MaTeJDVora12345/Linefollower/LF_3.0 - 26inter/KiCad/teensy41pinout.png

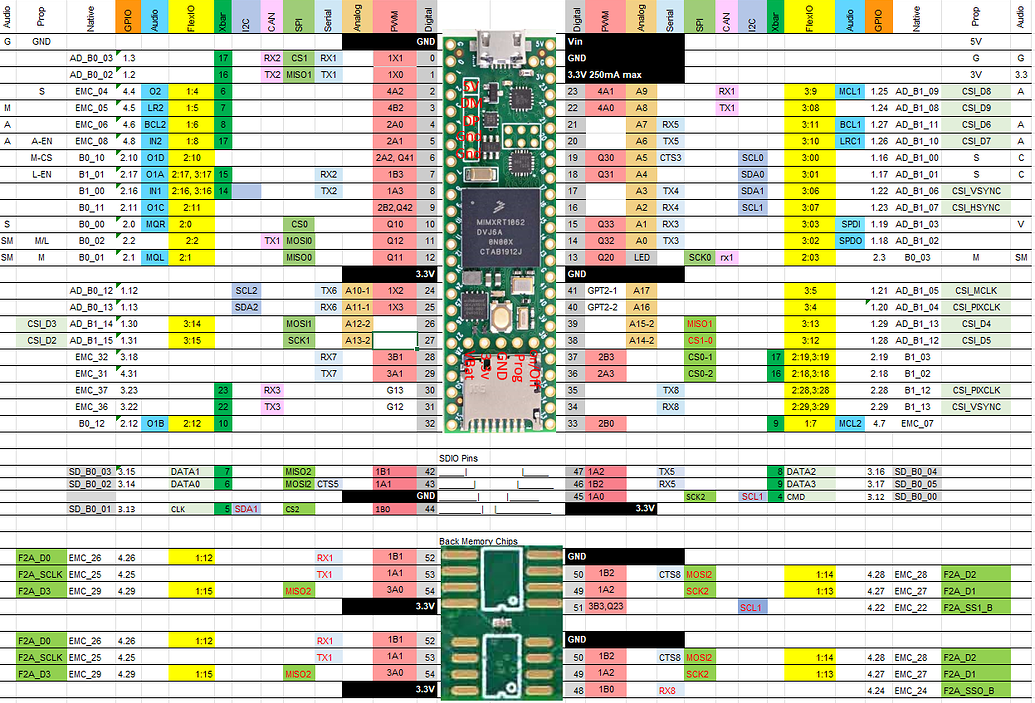
LF_3.0 - 26inter/KiCad/teensy41pinout.png
