MaTeJDVora12345/Linefollower/LF_3.0 - 26inter/KiCad/fusion/LinefollowerV4.step

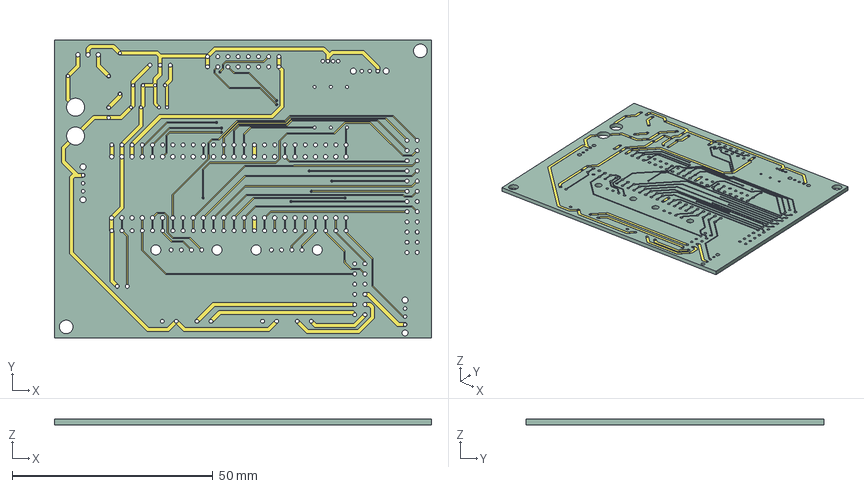
[picture p2: CAD file, 2026-03-14]
LF_3.0 - 26inter/KiCad/fusion/LinefollowerV4.step
94.0 x 74.2 x 1.48 mm
LinefollowerV4_copper
LinefollowerV4_via
LinefollowerV4_PCB
