MaTeJDVora12345/Linefollower/LF_3.0 - 26inter/KiCad/fusion/LinefollowerV4-B_Cu.dxf

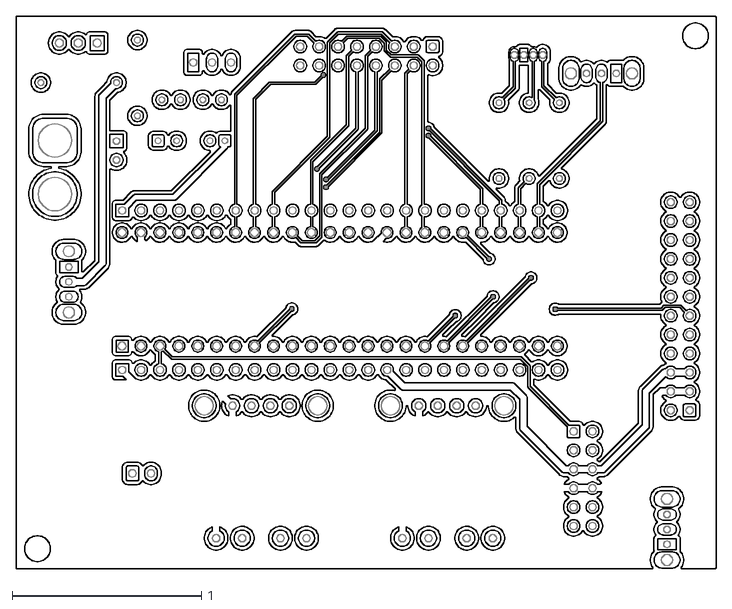
[picture p4: CAD file, 2026-03-14]
LF_3.0 - 26inter/KiCad/fusion/LinefollowerV4-B_Cu.dxf
3.70 x 2.92
