MaTeJDVora12345/Linefollower/LF_3.0 - 26inter/technicalDocumentation/technicalDraw.pdf

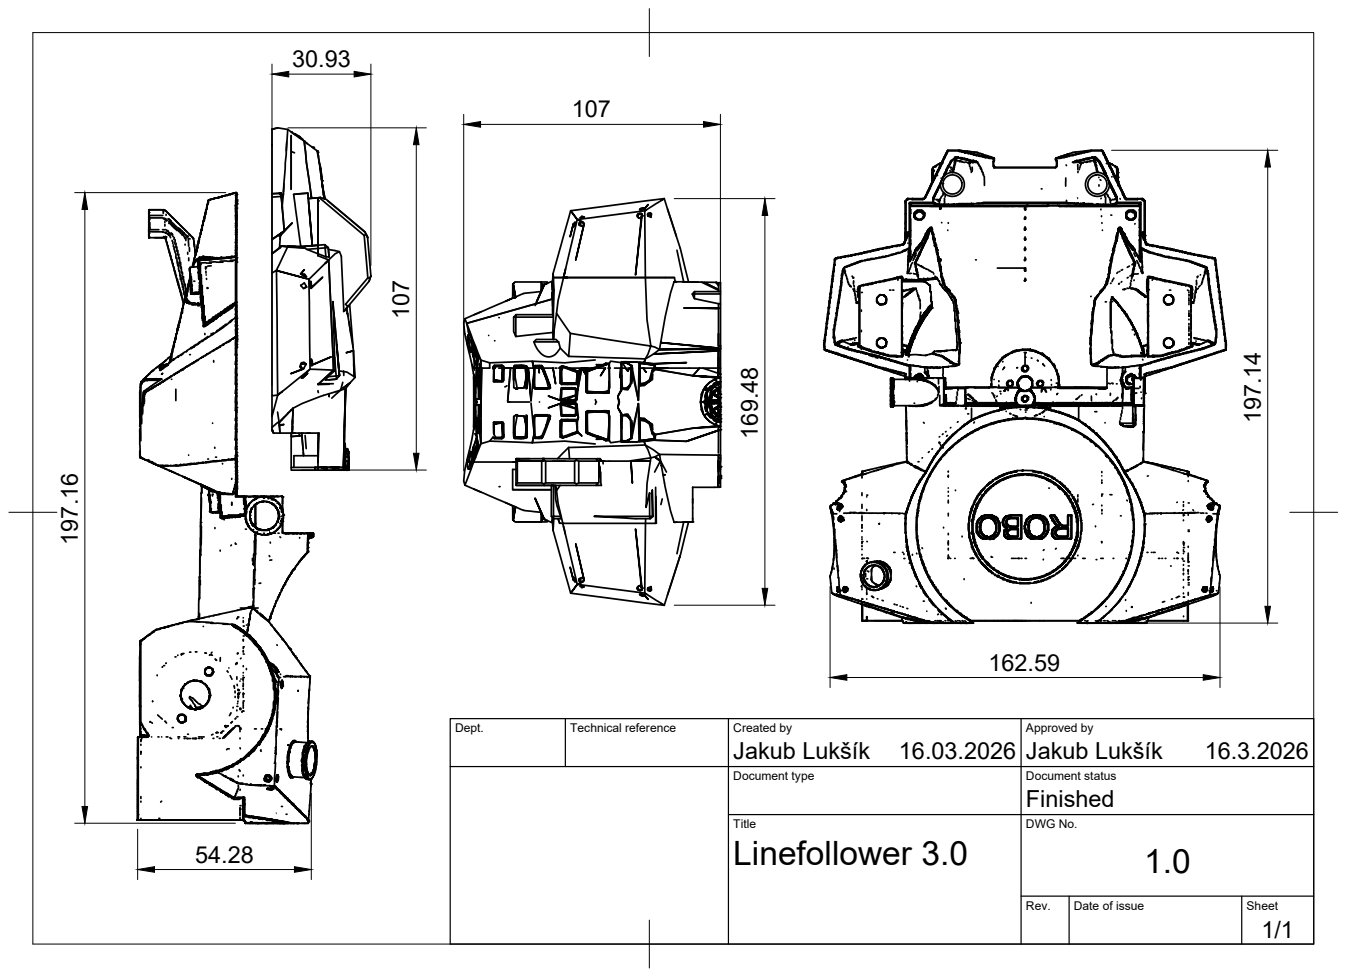
[picture p5: page 1]
Dept.; Technical reference; Created by; Approved by; Document type; Document status; Title; DWG No.; Rev.; Date of issue; Sheet; Linefollower 3.0; Jakub Lukšík; Jakub Lukšík 197.16
