MaTeJDVora12345/Linefollower/LF_3.0 - 26inter/KiCad/LinefollowerV4/LinefollowerV4.kicad_pcb

## KiCad design LF_3.0 - 26inter/KiCad/LinefollowerV4/LinefollowerV4.kicad_pcb (2026-03-14)

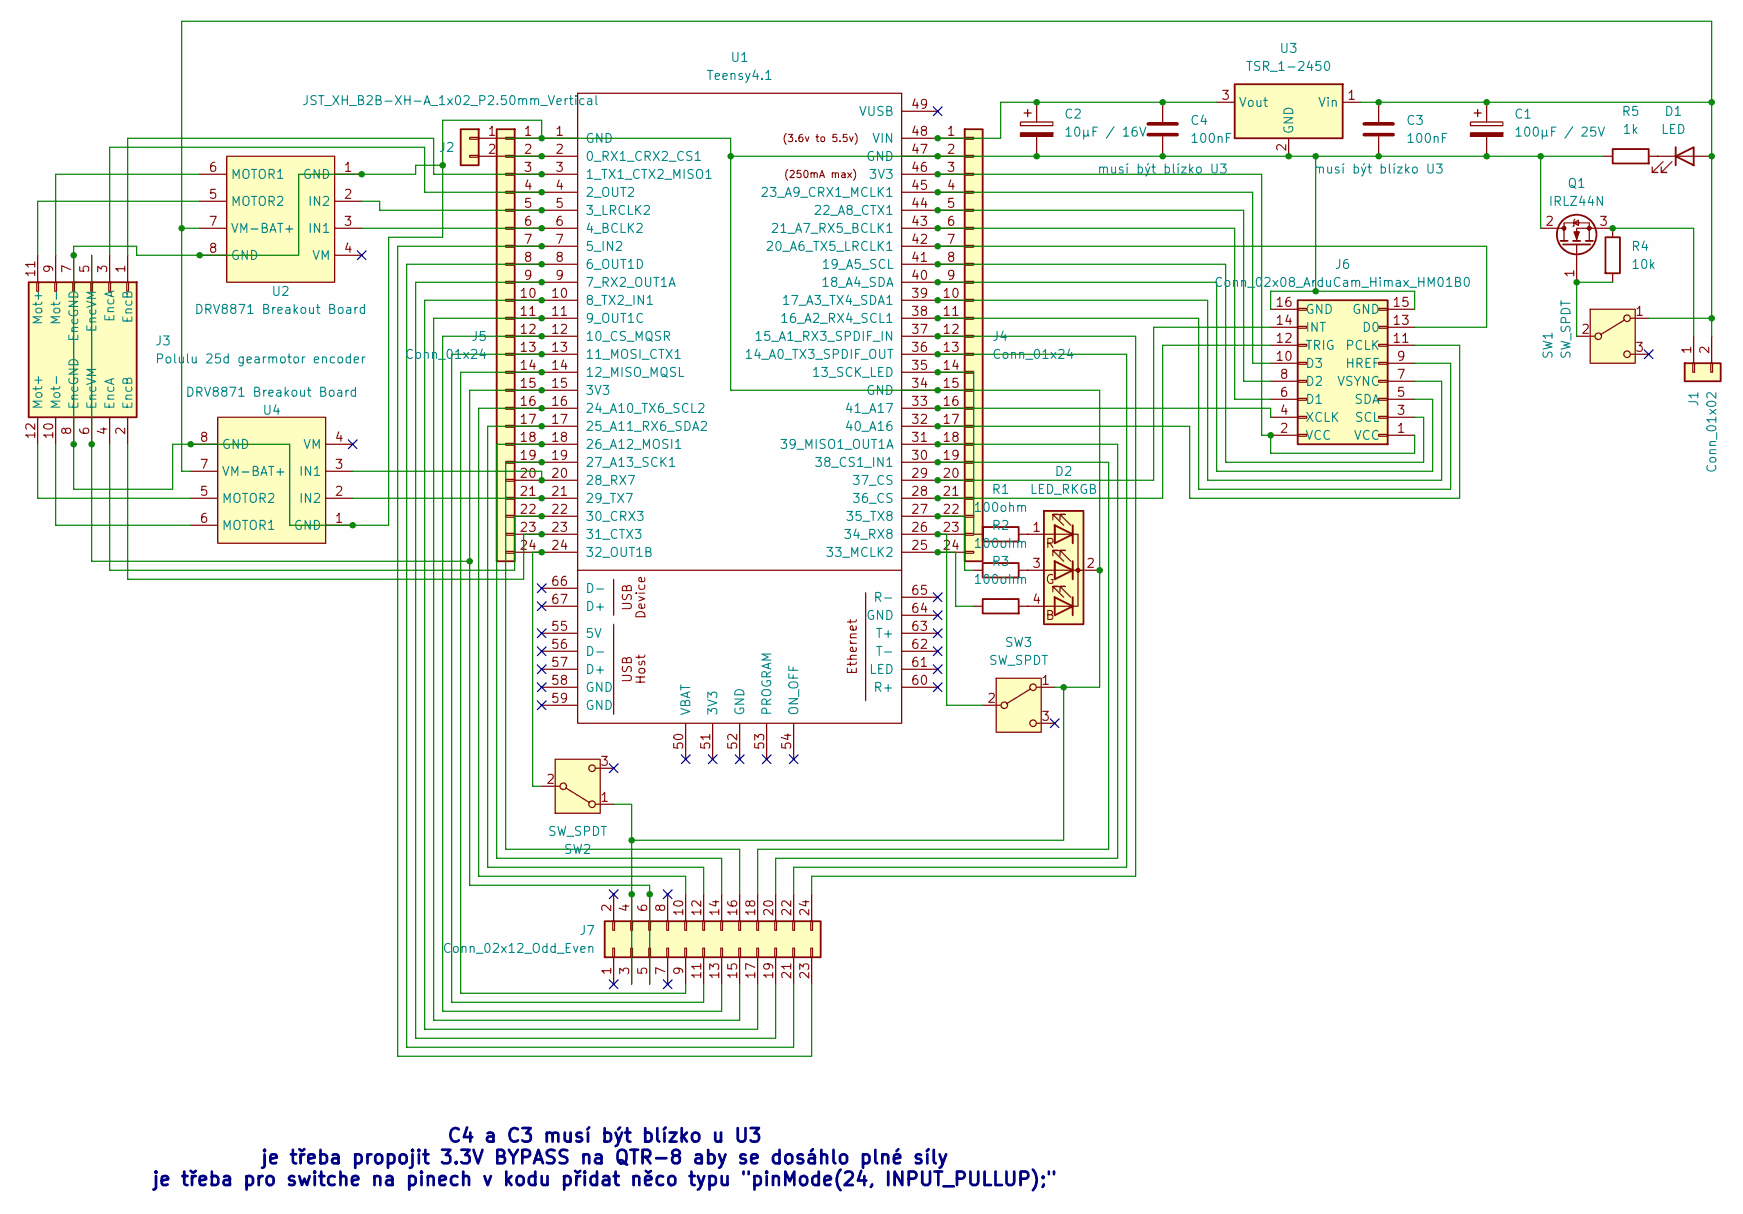
[picture p6: schematic LinefollowerV4.kicad_sch]

Parts:
C1: 100µF / 25V; CP_Radial_D6.3mm_P2.50mm
C2: 10µF / 16V; CP_Radial_D5.0mm_P2.00mm
C3, C4: 100nF; C_Disc_D5.0mm_W2.5mm_P2.50mm
D1: LED; LED_D5.0mm
D2: LED_RKGB; LED_RKBG_D5.0mm-4_RGB
J1: Conn_01x02; AMASS_XT60-M_1x02_P7.20mm_Vertical
J2: JST_XH_B2B-XH-A_1x02_P2.50mm_Vertical
J3: Polulu 25d gearmotor encoder; IDC-Header_2x06_P2.54mm_Vertical
J4, J5: Conn_01x24; PinHeader_1x24_P2.54mm_Vertical
J6: Conn_02x08_ArduCam_Himax_HM01B0; IDC-Header_2x08_P2.54mm_Vertical
J7: Conn_02x12_Odd_Even; IDC-Header_2x12_P2.54mm_Vertical_3D
Q1: IRLZ44N; TO-220-3_Vertical
R1, R2, R3: 100ohm; R_Axial_DIN0207_L6.3mm_D2.5mm_P10.16mm_Horizontal
R4: 10k; R_Axial_DIN0207_L6.3mm_D2.5mm_P10.16mm_Horizontal
R5: 1k; R_Axial_DIN0207_L6.3mm_D2.5mm_P10.16mm_Horizontal
SW1, SW2, SW3: SW_SPDT; SW_Slide_SPDT_Angled_CK_OS102011MA1Q
U1: Teensy4.1; Teensy41
U2, U4: DRV8871 Breakout Board
U3: TSR_1-2450; Converter_DCDC_TRACO_TSR-1_THT

Connections:
unnamed: C1.1, C3.1, D1.2 (A), J1.2, SW1.1 (A), U2.7 (VM-BAT+), U3.1 (Vin), U4.7 (VM-BAT+)
unnamed: D1.1 (K), R5.2
unnamed: D2.4 (BA), R3.2
unnamed: D2.3 (GA), R2.2
unnamed: C1.2, C2.2, C3.2, C4.2, D2.2 (K), J2.1, J3.7 (EncGND), J3.8 (EncGND), J4.2, J4.15, J5.1, J6.15 (GND), J6.16 (GND), J7.3, J7.4, Q1.2 (D), R5.1, SW2.1 (A), SW3.1 (A), U1.1 (GND), U1.34 (GND), U1.47 (GND), U2.1 (GND), U2.8 (GND), U3.2 (GND), U4.1 (GND), U4.8 (GND)
unnamed: D2.1 (RA), R1.2
unnamed: J1.1, Q1.3 (S), R4.1
unnamed: J2.2, J5.2, U1.2 (0_RX1_CRX2_CS1)
unnamed: C2.1, C4.1, J4.1, U1.48 (VIN), U3.3 (Vout)
unnamed: J4.3, J6.1 (VCC), J6.2 (VCC), U1.46 (3V3)
unnamed: J4.4, J6.10 (D3), U1.45 (23_A9_CRX1_MCLK1)
unnamed: J4.5, J6.8 (D2), U1.44 (22_A8_CTX1)
unnamed: J4.6, J6.6 (D1), U1.43 (21_A7_RX5_BCLK1)
unnamed: J4.7, J6.13 (D0), U1.42 (20_A6_TX5_LRCLK1)
unnamed: J4.8, J6.3 (SCL), U1.41 (19_A5_SCL)
unnamed: J4.9, J6.5 (SDA), U1.40 (18_A4_SDA)
unnamed: J4.10, J6.7 (VSYNC), U1.39 (17_A3_TX4_SDA1)
unnamed: J4.11, J6.9 (HREF), U1.38 (16_A2_RX4_SCL1)
unnamed: J4.12, J7.24, U1.37 (15_A1_RX3_SPDIF_IN)
unnamed: J4.13, J7.22, U1.36 (14_A0_TX3_SPDIF_OUT)
unnamed: J4.14, R1.1, U1.35 (13_SCK_LED)
unnamed: J4.16, J6.4 (XCLK), U1.33 (41_A17)
unnamed: J4.17, J6.11 (PCLK), U1.32 (40_A16)
unnamed: J4.18, J7.20, U1.31 (39_MISO1_OUT1A)
unnamed: J4.19, J7.18, U1.30 (38_CS1_IN1)
unnamed: J4.20, J6.14 (INT), U1.29 (37_CS)
unnamed: J4.21, J6.12 (TRIG), U1.28 (36_CS)
unnamed: J4.22, R2.1, U1.27 (35_TX8)
unnamed: J4.23, SW3.2 (B), U1.26 (34_RX8)
unnamed: J4.24, R3.1, U1.25 (33_MCLK2)
unnamed: J3.1 (EncB), J5.3, U1.3 (1_TX1_CTX2_MISO1)
unnamed: J3.3 (EncA), J5.4, U1.4 (2_OUT2)
unnamed: J5.5, U1.5 (3_LRCLK2), U2.2 (IN2)
unnamed: J5.6, U1.6 (4_BCLK2), U2.3 (IN1)
unnamed: J5.7, J7.23, U1.7 (5_IN2)
unnamed: J5.8, J7.21, U1.8 (6_OUT1D)
unnamed: J5.9, J7.19, U1.9 (7_RX2_OUT1A)
unnamed: J5.10, J7.17, U1.10 (8_TX2_IN1)
unnamed: J5.11, J7.15, U1.11 (9_OUT1C)
unnamed: J5.12, J7.13, U1.12 (10_CS_MQSR)
unnamed: J5.13, J7.11, U1.13 (11_MOSI_CTX1)
unnamed: J5.14, J7.9, U1.14 (12_MISO_MQSL)
unnamed: J3.5 (EncVM), J3.6 (EncVM), J5.15, J7.5, J7.6, U1.15 (3V3)
unnamed: J5.16, J7.10, U1.16 (24_A10_TX6_SCL2)
unnamed: J5.17, J7.12, U1.17 (25_A11_RX6_SDA2)
unnamed: J5.18, J7.14, U1.18 (26_A12_MOSI1)
unnamed: J5.19, J7.16, U1.19 (27_A13_SCK1)
unnamed: J5.20, U1.20 (28_RX7), U4.3 (IN1)
unnamed: J5.21, U1.21 (29_TX7), U4.2 (IN2)
unnamed: J3.4 (EncA), J5.22, U1.22 (30_CRX3)
unnamed: J3.2 (EncB), J5.23, U1.23 (31_CTX3)
unnamed: J5.24, SW2.2 (B), U1.24 (32_OUT1B)
unnamed: Q1.1 (G), R4.2, SW1.2 (B)
unnamed: J3.9 (Mot-), U2.6 (MOTOR1)
unnamed: J3.11 (Mot+), U2.5 (MOTOR2)
unnamed: J3.10 (Mot-), U4.6 (MOTOR1)
unnamed: J3.12 (Mot+), U4.5 (MOTOR2)

Notes on the sheet:
C4 a C3 musí být blízko u U3 je třeba propojit 3.3V BYPASS na QTR-8 aby se dosáhlo plné síly je třeba pro switche na pinech v kodu přidat něco typu "pinMode(24, INPUT_PULLUP);"

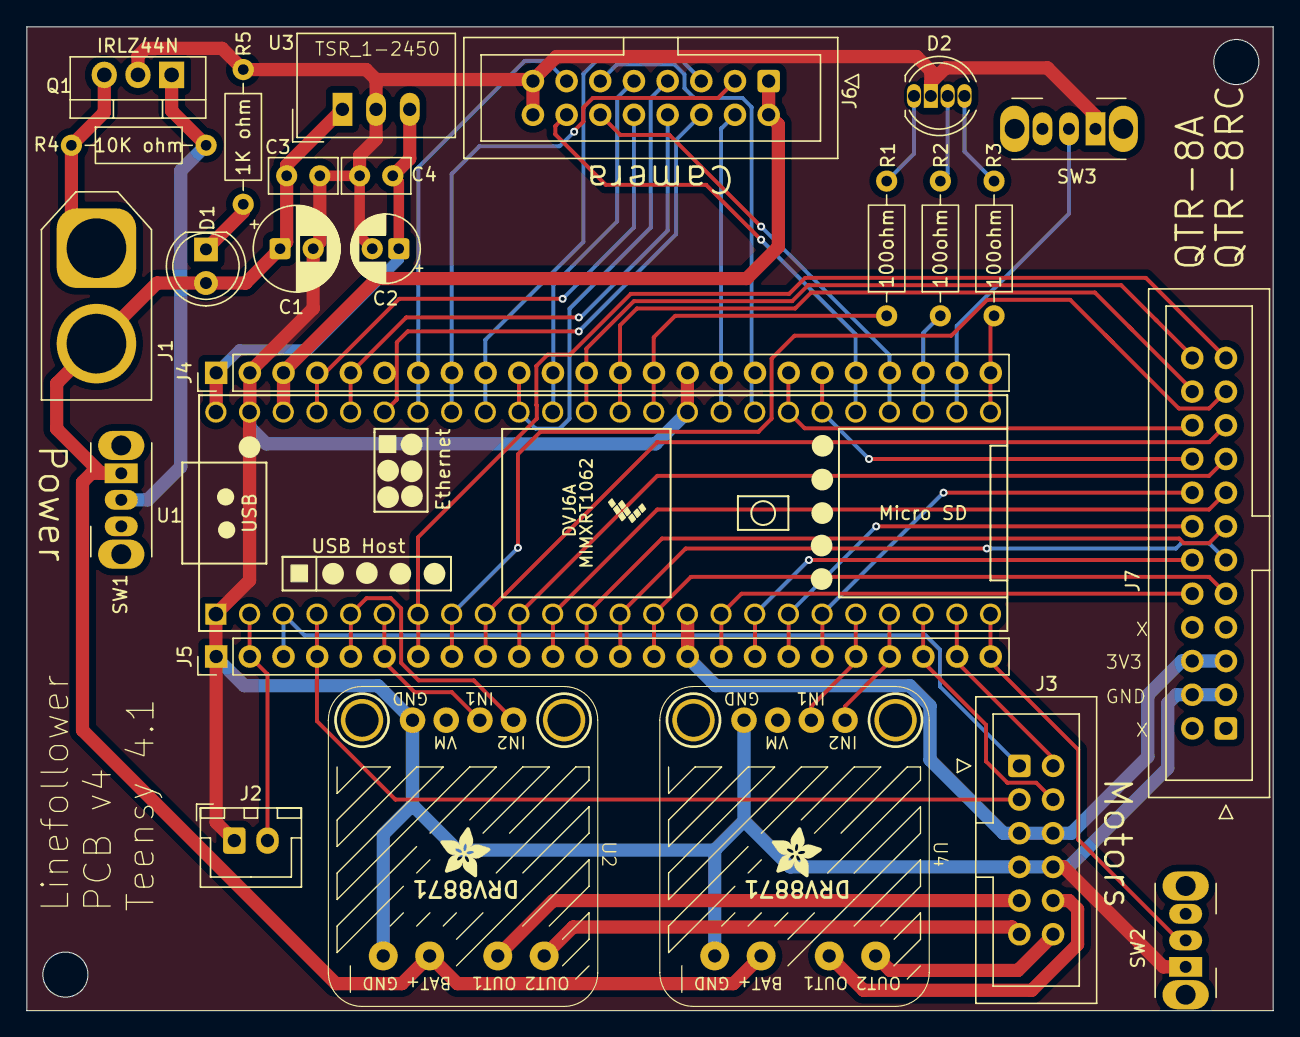
[picture p7: board LinefollowerV4.kicad_pcb from above]

Board: 2 copper layers, 94.0 x 74.2 mm, 26 parts (0 on the bottom side), 57 nets.
