MaTeJDVora12345/Linefollower/LF_3.0 - 26inter/KiCad/customPCB/customPCB.kicad_pcb

## KiCad design LF_3.0 - 26inter/KiCad/customPCB/customPCB.kicad_pcb (2026-03-14)

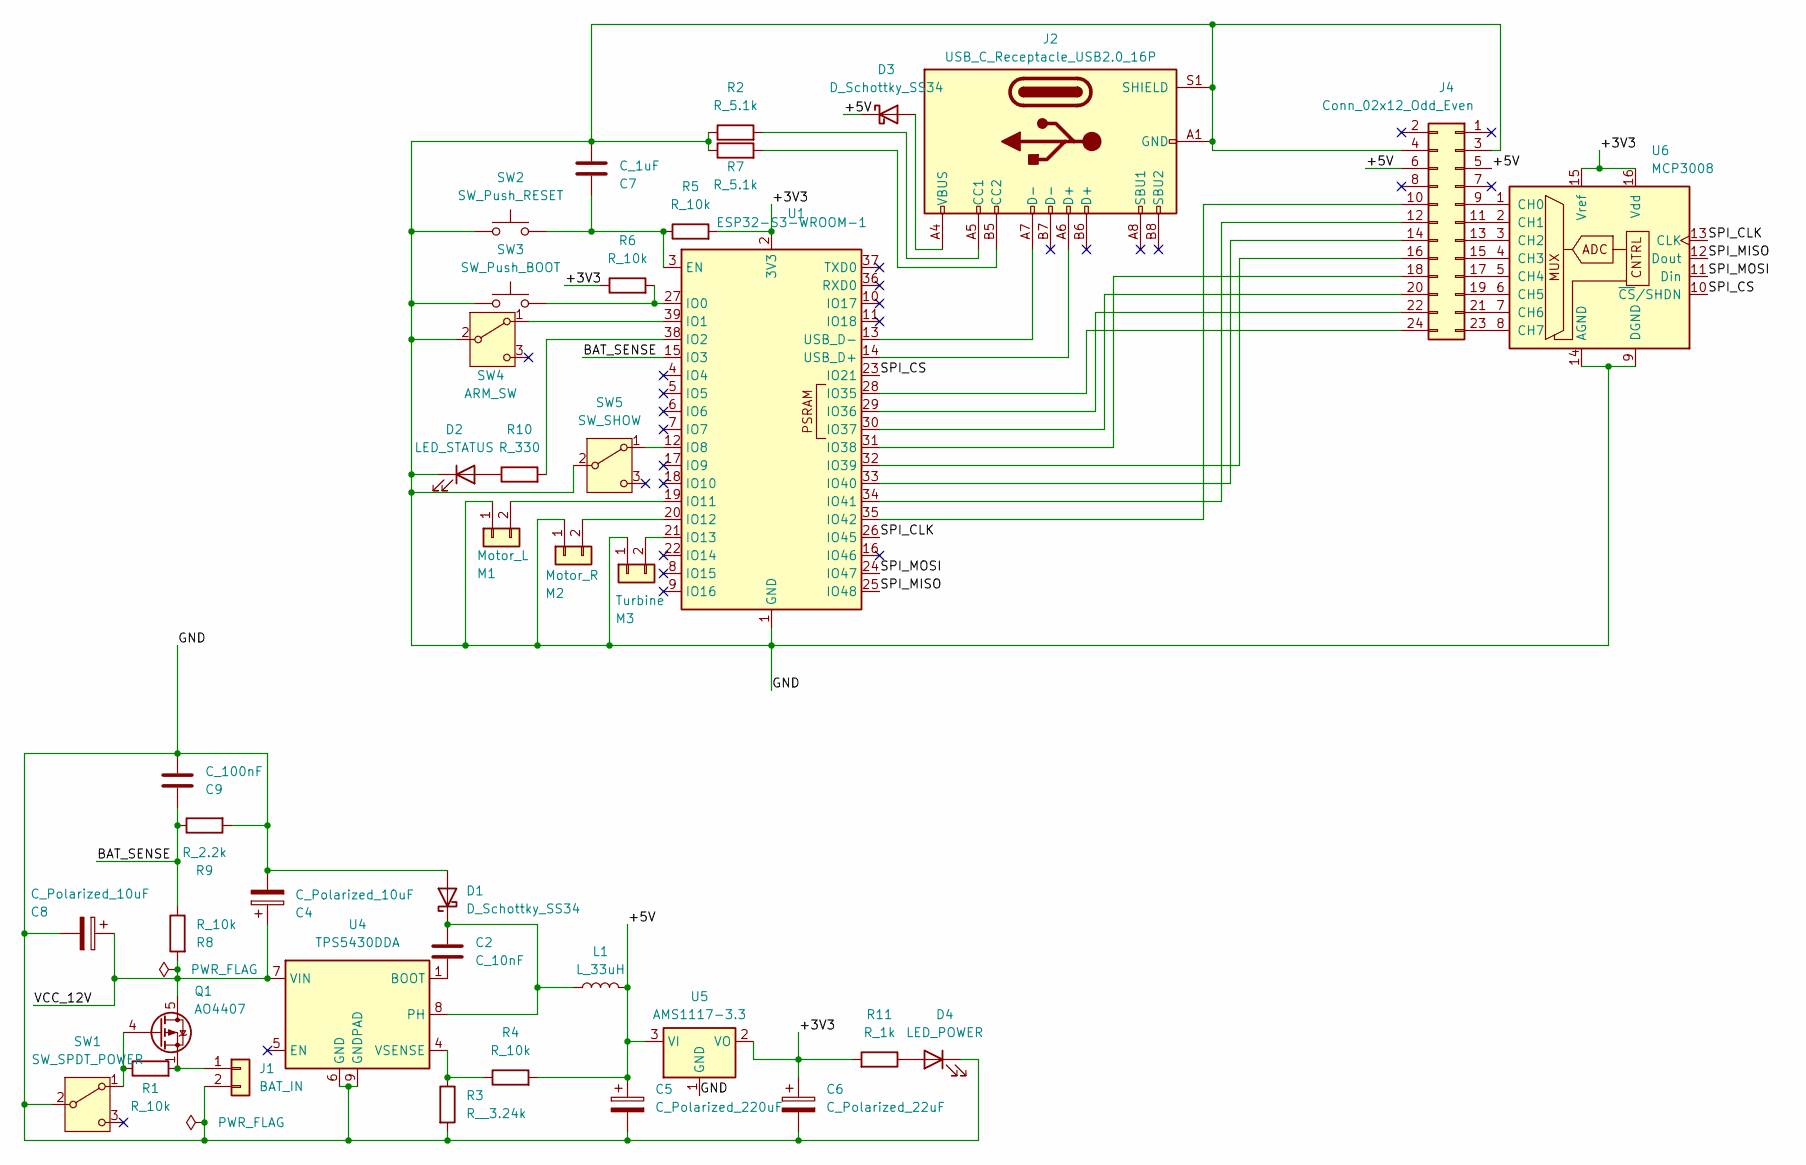
[picture p8: schematic customPCB.kicad_sch, Custom PCB for Linefollower]

Parts:
C2: C_10nF; C_0603_1608Metric
C4, C8: C_Polarized_10uF; C_1206_3216Metric
C5: C_Polarized_220uF; CP_Elec_6.3x5.4
C6: C_Polarized_22uF; C_1206_3216Metric
C7: C_1uF; C_0603_1608Metric
C9: C_100nF; C_0603_1608Metric
D1, D3: D_Schottky_SS34; D_SMA
D2: LED_STATUS; LED_0603_1608Metric
D4: LED_POWER; LED_0603_1608Metric
J1: BAT_IN; AMASS_XT60-F_1x02_P7.20mm_Vertical
J2: USB_C_Receptacle_USB2.0_16P; USB_C_Receptacle_GCT_USB4085
J4: Conn_02x12_Odd_Even; IDC-Header_2x12_P2.54mm_Vertical_3D
L1: L_33uH; L_Taiyo-Yuden_NR-60xx
M1: Motor_L; JST_XH_B2B-XH-A_1x02_P2.50mm_Vertical
M2: Motor_R; JST_XH_B2B-XH-A_1x02_P2.50mm_Vertical
M3: Turbine; JST_XH_B2B-XH-A_1x02_P2.50mm_Vertical
Q1: AO4407; SOIC-8_3.9x4.9mm_P1.27mm
R1, R4, R5, R6, R8: R_10k; R_0603_1608Metric
R2, R7: R_5.1k; R_0603_1608Metric
R3: R__3.24k; R_0603_1608Metric
R9: R_2.2k; R_0603_1608Metric
R10: R_330; R_0603_1608Metric
R11: R_1k; R_0603_1608Metric
SW1: SW_SPDT_POWER; SW_SPDT_PCM12
SW2: SW_Push_RESET; SW_SPST_B3U-1000P
SW3: SW_Push_BOOT; SW_SPST_B3U-1000P
SW4: ARM_SW; SW_SPDT_PCM12
SW5: SW_SHOW; SW_SPDT_PCM12
U1: ESP32-S3-WROOM-1
U4: TPS5430DDA; TI_SO-PowerPAD-8_ThermalVias
U5: AMS1117-3.3; SOT-223-3_TabPin2
U6: MCP3008; SOIC-16_3.9x9.9mm_P1.27mm

Connections:
/+3V3: C6.1, R5.2, R6.1, R11.2, U1.2 (3V3), U5.2 (VO), U6.15 (Vref), U6.16 (Vdd)
/+5V: C5.1, D3.1 (K), J4.5, J4.6, L1.2, R4.2, U5.3 (VI)
/BAT_SENSE: C9.1, R8.1, R9.1, U1.15 (IO3)
/GND: C4.2, C5.2, C6.2, C7.2, C8.2, C9.2, D1.2 (A), D2.1 (K), D4.1 (K), J1.2, J2.A1 (GND), J2.A12 (GND), J2.B1 (GND), J2.B12 (GND), J2.S1 (SHIELD), J4.3, J4.4, M1.1, M2.1, M3.1, R2.1, R3.2, R7.1, R9.2, SW1.2 (B), SW2.1, SW3.1, SW4.2 (B), SW5.2 (B), U1.1 (GND), U1.40 (GND), U1.41 (GND), U4.6 (GND), U4.9 (GNDPAD), U5.1 (GND), U6.9 (DGND), U6.14 (AGND)
/SPI_CLK: U1.26 (IO45), U6.13 (CLK)
/SPI_CS: U1.23 (IO21), U6.10 (~CS/SHDN)
/SPI_MISO: U1.25 (IO48), U6.12 (Dout)
/SPI_MOSI: U1.24 (IO47), U6.11 (Din)
/VCC_12V: C4.1, C8.1, Q1.5 (D), Q1.6 (D), Q1.7 (D), Q1.8 (D), R8.2, U4.7 (VIN)
unnamed: C2.1, D1.1 (K), L1.1, U4.8 (PH)
unnamed: D2.2 (A), R10.1
unnamed: D3.2 (A), J2.A4 (VBUS), J2.A9 (VBUS), J2.B4 (VBUS), J2.B9 (VBUS)
unnamed: D4.2 (A), R11.1
unnamed: J1.1, Q1.1 (S), Q1.2 (S), Q1.3 (S), R1.2
unnamed: J2.A5 (CC1), R2.2
unnamed: J2.B5 (CC2), R7.2
unnamed: J4.9, U6.1 (CH0)
unnamed: J4.10, U1.35 (IO42)
unnamed: J4.11, U6.2 (CH1)
unnamed: J4.12, U1.34 (IO41)
unnamed: J4.13, U6.3 (CH2)
unnamed: J4.14, U1.33 (IO40)
unnamed: J4.15, U6.4 (CH3)
unnamed: J4.16, U1.32 (IO39)
unnamed: J4.17, U6.5 (CH4)
unnamed: J4.18, U1.31 (IO38)
unnamed: J4.19, U6.6 (CH5)
unnamed: J4.20, U1.30 (IO37)
unnamed: J4.21, U6.7 (CH6)
unnamed: J4.22, U1.29 (IO36)
unnamed: J4.23, U6.8 (CH7)
unnamed: J4.24, U1.28 (IO35)
unnamed: M1.2, U1.19 (IO11)
unnamed: M2.2, U1.20 (IO12)
unnamed: M3.2, U1.21 (IO13)
unnamed: Q1.4 (G), R1.1, SW1.1 (A)
unnamed: SW4.1 (A), U1.39 (IO1)
unnamed: SW5.1 (A), U1.12 (IO8)
unnamed: C7.1, R5.1, SW2.2, U1.3 (EN)
unnamed: R6.2, SW3.2, U1.27 (IO0)
unnamed: R10.2, U1.38 (IO2)
unnamed: J2.A6 (D+), U1.14 (USB_D+)
unnamed: J2.A7 (D-), U1.13 (USB_D-)
unnamed: C2.2, U4.1 (BOOT)
unnamed: R3.1, R4.1, U4.4 (VSENSE)

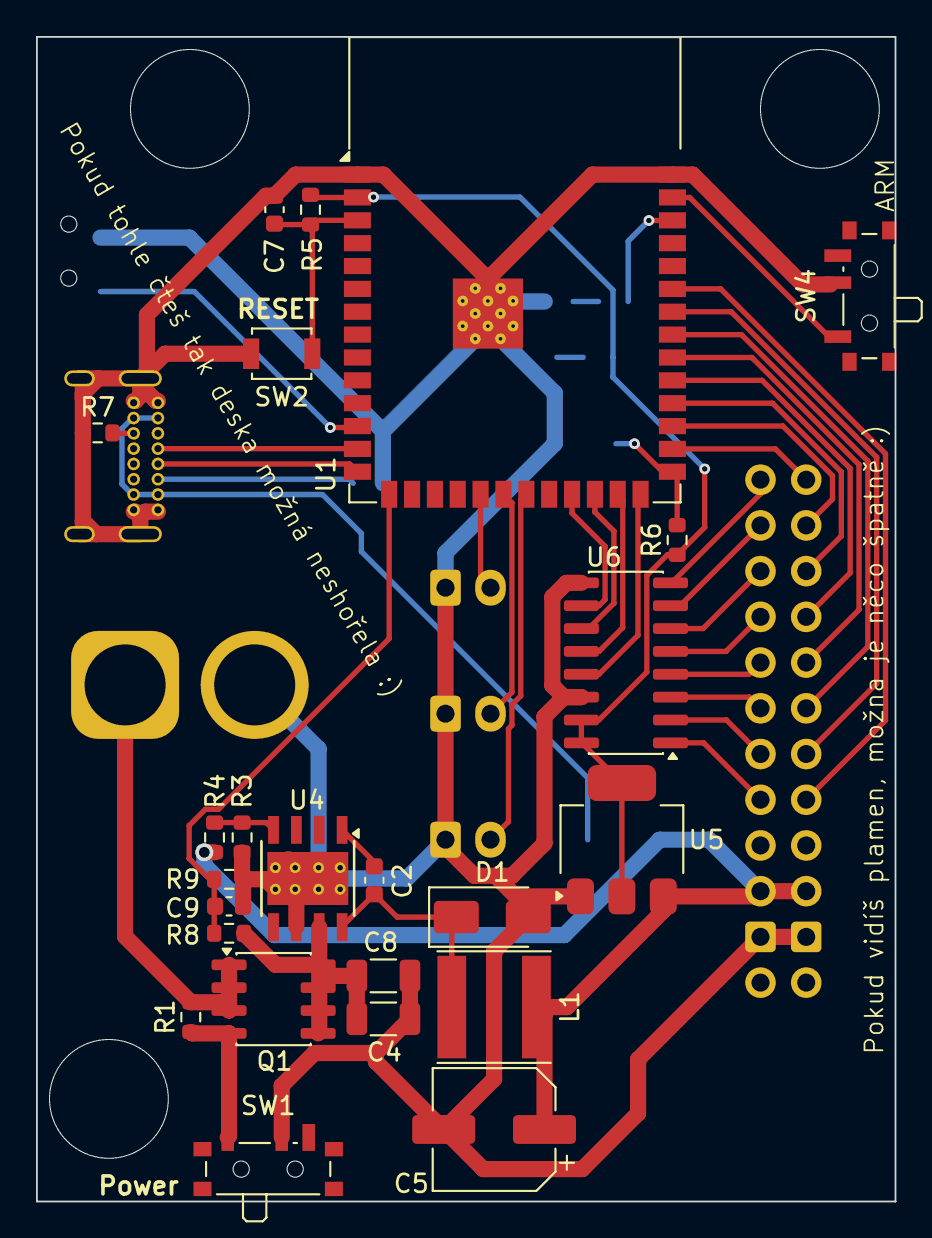
[picture p9: board customPCB.kicad_pcb from above]

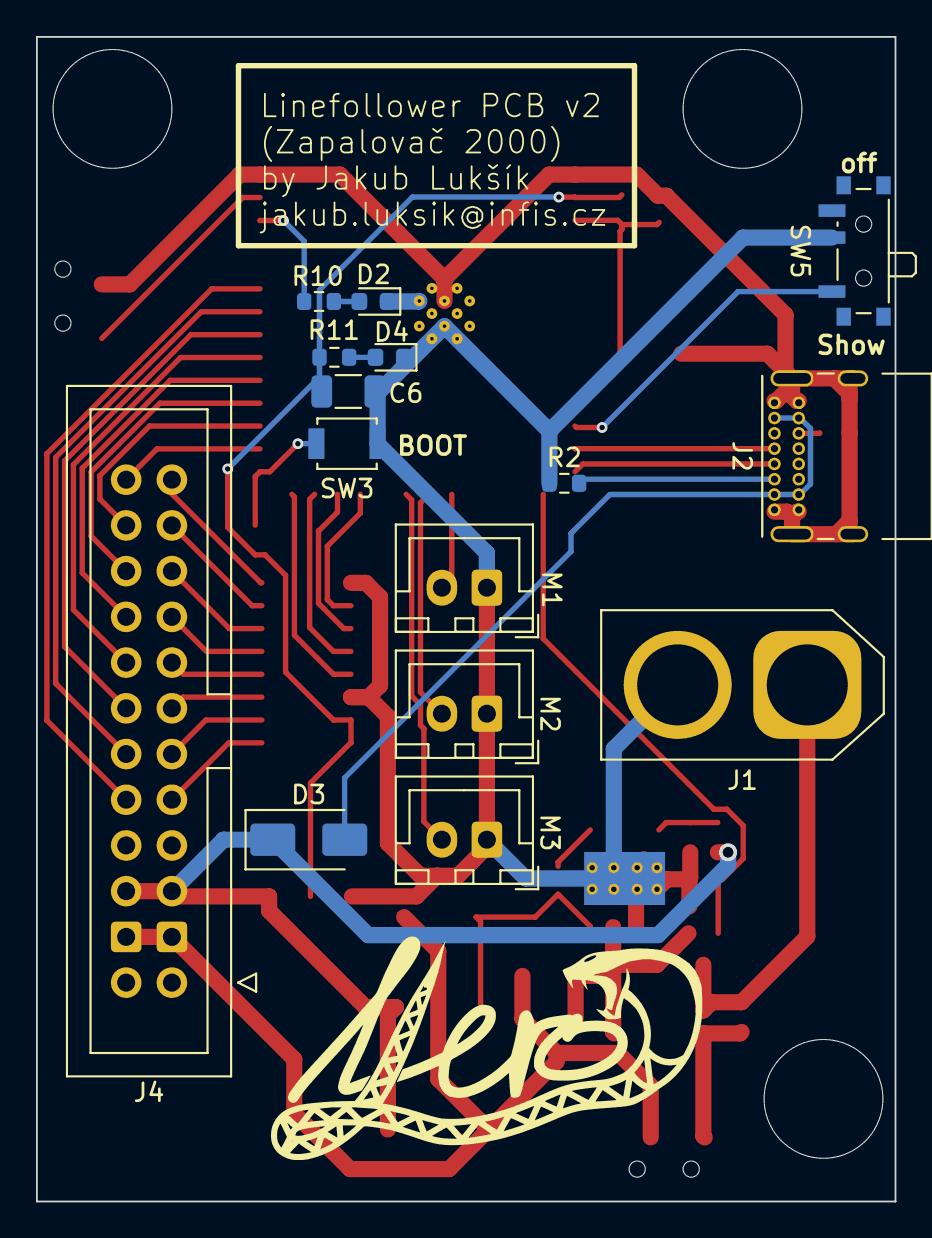
[picture p10: board customPCB.kicad_pcb from below]

Board: 2 copper layers, 47.7 x 64.7 mm, 39 parts (15 on the bottom side), 45 nets.
