MaTeJDVora12345/Linefollower/(commit log)

2026-03-12 Update and rename hnibshooooooooaruúirersrrrrrrrrrrrrrrrrrrrrrrrrrrrrrrrrrrrrrrrr.py to sensorTest.py
2026-03-14 added KiCad files to repo
    [LinefollowerESPv3.kicad_pcb, LinefollowerESPv3.kicad_sch, LinefollowerV4-B_Cu.dxf, LinefollowerV4-F_Cu.dxf, LinefollowerV4.kicad_pcb, LinefollowerV4.kicad_sch, LinefollowerV4.step, LinefollowerV4manual.kicad_pcb]
